v973588/SertaoBee/imagens/receptor.jpeg

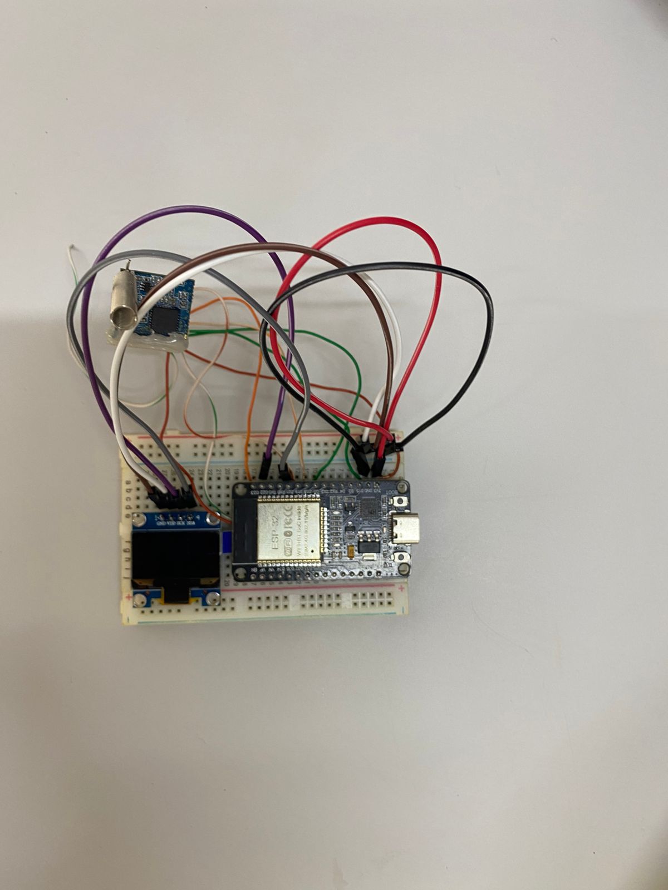
imagens/receptor.jpeg
