v973588/SertaoBee/imagens/transmissor.jpeg

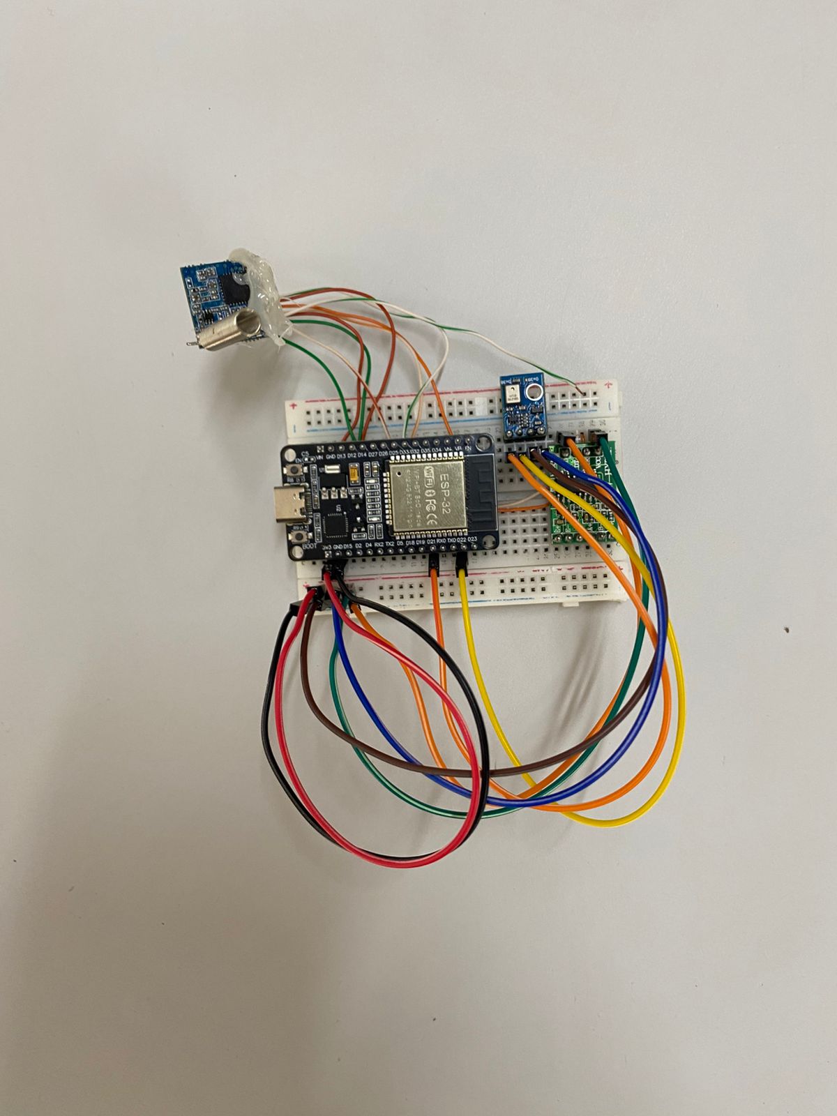
imagens/transmissor.jpeg
