v973588/SertaoBee/(commit log)

2026-05-19 feat: Adição de arquivos iniciais
2026-05-19 feat: Codigo inicial de teste do transmissor
2026-05-19 feat: Codigo inicial de teste do receptor
2026-05-19 refactor: Ajuste na estrutura de arquivos do projeto
2026-05-19 docs: Adição de ligacoes.md
2026-05-23 feat: Adição de um servidor Web Local onde serão exibidos as informações vindas das colmeias - Simples alterações nos Docs - Pequenos ajustes na Apresentação
